Nick-Zuchlewski/nix-pill-v1/assembly/nix-pill-v1.xlsx

Designator | Package | Quantity | Designation | Part Number | Cost | Total | Link
C1,C4,C8,C10,C11,C12,C13 | C_0603_1608Metric | 7 | 100n | CL10B104KB8NNNL | $0.10 | $0.70 | https://www.digikey.com/en/products/detail/samsung-electro-mechanics/CL10B104KB8NNNL/3894274
C2,C5 | C_0603_1608Metric | 2 | 8pF | C1608CH2A080D080AA | $0.17 | $0.34 | https://www.digikey.com/en/products/detail/tdk-corporation/C1608CH2A080D080AA/3948350
C3,C6 | C_0603_1608Metric | 2 | 10pF | C1608CH2A100D080AA | $0.17 | $0.34 | https://www.digikey.com/en/products/detail/tdk-corporation/C1608CH2A100D080AA/3948352
C7 | CP_Elec_4x3 | 1 | 100n | 865230640001 | $0.17 | $0.17 | https://www.digikey.com/en/products/detail/w%C3%BCrth-elektronik/865230640001/5727861
C9 | CP_Elec_4x3 | 1 | 10u | UWX1C100MCL1GB | $0.25 | $0.25 | https://www.digikey.com/en/products/detail/nichicon/UWX1C100MCL1GB/589841
D1 | LED_0603_1608Metric | 1 | C13 | LTST-C190KRKT | $0.24 | $0.24 | https://www.digikey.com/en/products/detail/lite-on-inc/LTST-C190KRKT/386817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
D2 | LED_0603_1608Metric | 1 | PWR | LTST-C190KRKT | $0.24 | $0.24 | https://www.digikey.com/en/products/detail/lite-on-inc/LTST-C190KRKT/386817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
D3 | SOT-23 | 1 | BAT54C | BAT54CLT1G | $0.14 | $0.14 | https://www.digikey.com/en/products/detail/on-semiconductor/BAT54CLT1G/920481
J1 | PinHeader_1x20_P2.54mm_Vertical | 1 | LEFT | 22284205 | $1.17 | $1.17 | https://www.digikey.com/en/products/detail/molex/0022284205/313945
J2 | PinHeader_2x03_P2.54mm_Vertical | 1 | BOOT | 877580650 | $0.44 | $0.44 | https://www.digikey.com/en/products/detail/molex/0877580650/3264792
J3 | PinHeader_1x20_P2.54mm_Vertical | 1 | RIGHT | 22284205 | $1.17 | $1.17 | https://www.digikey.com/en/products/detail/molex/0022284205/313945
J4 | PinHeader_1x04_P2.54mm_Horizontal | 1 | SWD | PBC04SBAN | $0.45 | $0.45 | https://www.digikey.com/en/products/detail/sullins-connector-solutions/PBC04SBAN/860344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
J5 | USB_Micro-B_Amphenol_10103594-0001LF_Horizontal | 1 | USB_B_Micro | 10103594-0001LF | $0.75 | $0.75 | https://www.digikey.com/en/products/detail/amphenol-icc-fci/10103594-0001LF/2350351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
R1,R2 | R_0603_1608Metric | 2 | 100 | RT0603DRD07100RL | $0.17 | $0.34 | https://www.digikey.com/en/products/detail/yageo/RT0603DRD07100RL/1035412
R3,R4,R8 | R_0603_1608Metric | 3 | 10k | RT0603DRD0710KL | $0.17 | $0.51 | https://www.digikey.com/en/products/detail/yageo/RT0603DRD0710KL/1035416
R5 | R_0603_1608Metric | 1 | 10K | RT0603DRD0710KL | $0.17 | $0.17 | https://www.digikey.com/en/products/detail/yageo/RT0603DRD0710KL/1035417
R6,R7 | R_0603_1608Metric | 2 | 22 | RC0603JR-0722RL | $0.10 | $0.20 | https://www.digikey.com/en/products/detail/yageo/RC0603JR-0722RL/726743
R9 | R_0603_1608Metric | 1 | 1M | CPF0603B1M0E1 | $0.59 | $0.59 | https://www.digikey.com/en/products/detail/te-connectivity-passive-product/CPF0603B1M0E1/2389636
SW1 | SW_SPST_TL3305A | 1 | USER0 | TL3305AF160QG | $0.18 | $0.18 | https://www.digikey.com/en/products/detail/e-switch/TL3305AF160QG/5816181
SW2 | SW_SPST_TL3305A | 1 | NRST | TL3305AF160QG | $0.18 | $0.18 | https://www.digikey.com/en/products/detail/e-switch/TL3305AF160QG/5816182
U1 | SOT-223-3_TabPin2 | 1 | AMS1117-3.3 | LD1117S33TR | $0.41 | $0.41 | https://www.digikey.com/en/products/detail/stmicroelectronics/LD1117S33TR/585766
U2 | LQFP-48_7x7mm_P0.5mm | 1 | STM32F103C8Tx | STM32F103C8T6 | $5.77 | $5.77 | https://www.digikey.com/en/products/detail/stmicroelectronics/STM32F103C8T6/1646338
Y1 | Crystal_SMD_MicroCrystal_CC5V-T1A-2Pin_4.1x1.5mm | 1 | 32.768KHz LSE | CC5V-T1A-32.768KHZ-9PF-20PPM-TA-QC | $1.18 | $1.18 | https://www.digikey.com/en/products/detail/micro-crystal-ag/CC5V-T1A-32-768KHZ-9PF-20PPM-TA-QC/10499123
Y2 | Crystal_SMD_3225-4Pin_3.2x2.5mm | 1 | 8MHz HSE | RH100-8.000-10-1010-EXT-TR | $0.82 | $0.82 | https://www.digikey.com/en/products/detail/raltron-electronics/RH100-8-000-10-1010-EXT-TR/10272912
 |  |  |  |  | Total | $16.75
