Nick-Zuchlewski/nix-pill-v1/nix-pill-v1.kicad_pcb

## KiCad design nix-pill-v1.kicad_pcb (2021-02-02)

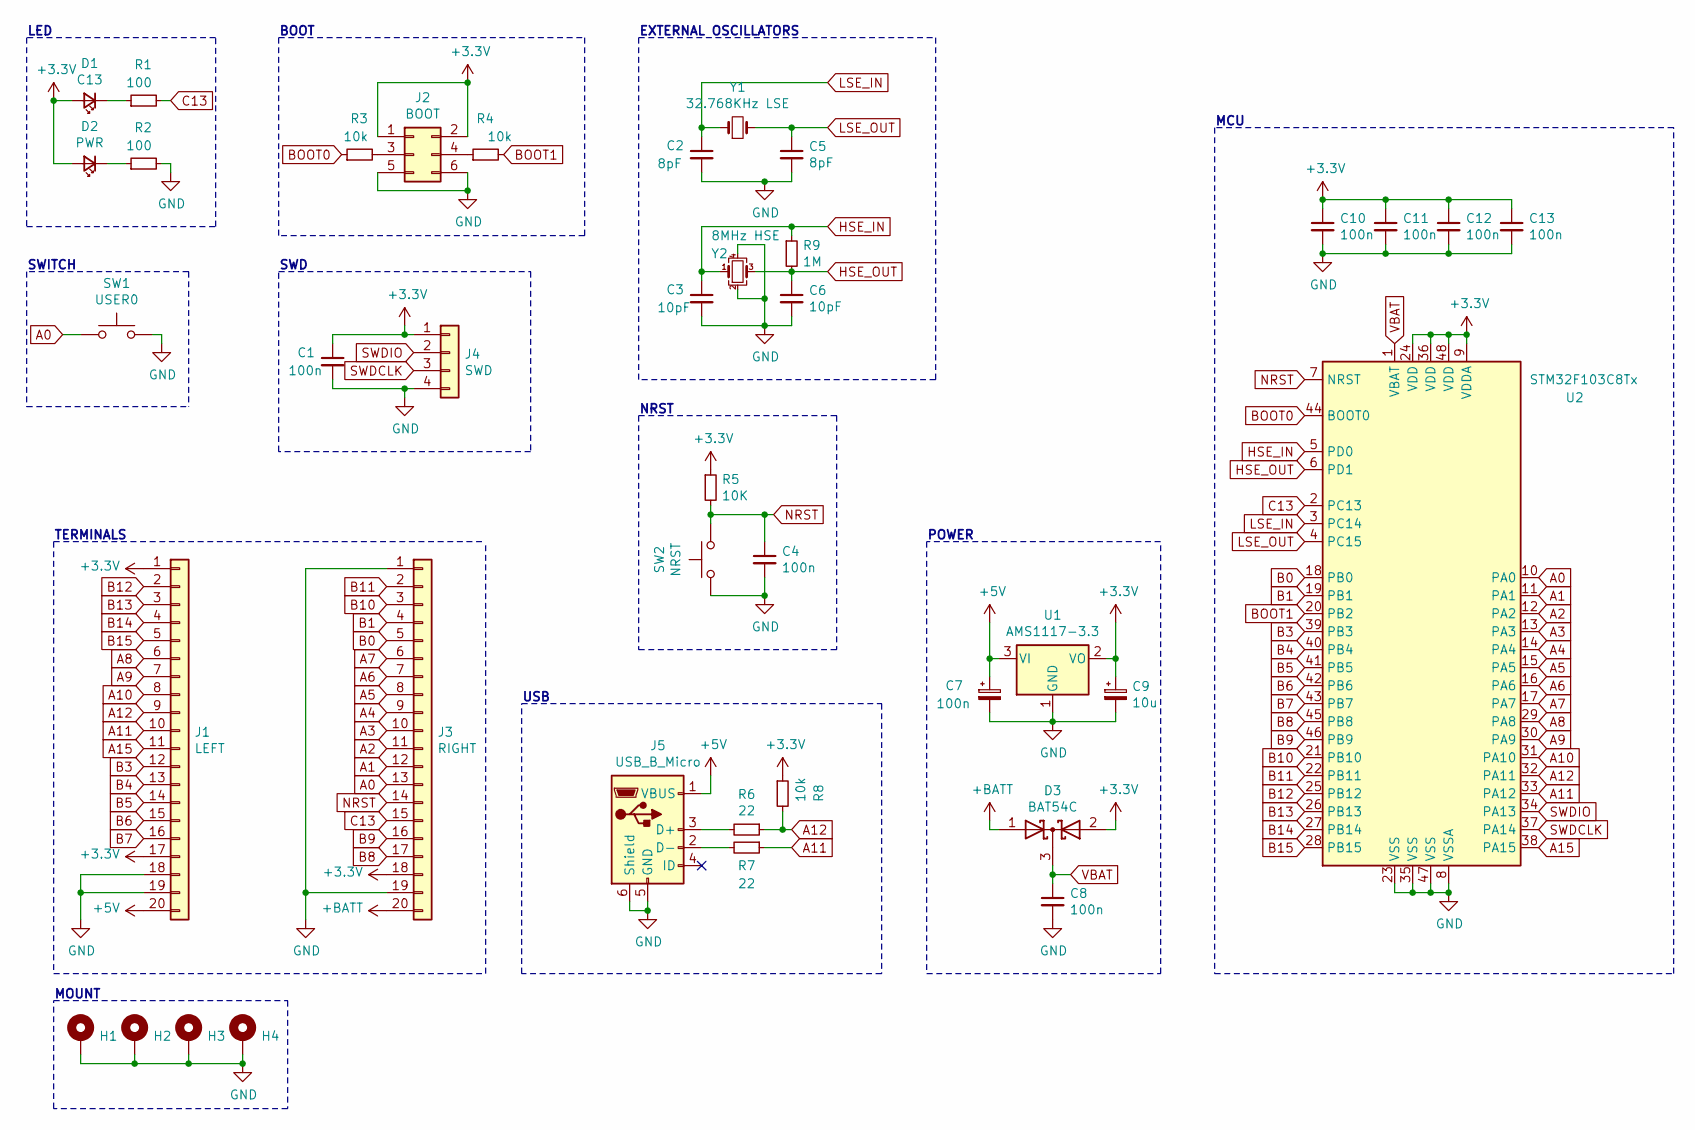
[picture p1: schematic nix-pill-v1.sch]

Parts:
C1, C4, C8, C10, C11, C12, C13: 100n; C_0603_1608Metric
C2, C5: 8pF; C_0603_1608Metric
C3, C6: 10pF; C_0603_1608Metric
C7: 100n; CP_Elec_4x3
C9: 10u; CP_Elec_4x3
D1: C13; LED_0603_1608Metric
D2: PWR; LED_0603_1608Metric
D3: BAT54C; SOT-23
H1, H2, H3, H4: MountingHole_Pad; MountingHole_4.3mm_M4_Pad_Via
J1: LEFT; PinHeader_1x20_P2.54mm_Vertical
J2: BOOT; PinHeader_2x03_P2.54mm_Vertical
J3: RIGHT; PinHeader_1x20_P2.54mm_Vertical
J4: SWD; PinHeader_1x04_P2.54mm_Horizontal
J5: USB_B_Micro; USB_Micro-B_Amphenol_10103594-0001LF_Horizontal
R1, R2: 100; R_0603_1608Metric
R3, R4, R8: 10k; R_0603_1608Metric
R5: 10K; R_0603_1608Metric
R6, R7: 22; R_0603_1608Metric
R9: 1M; R_0603_1608Metric
SW1: USER0; SW_SPST_TL3305A
SW2: NRST; SW_SPST_TL3305A
U1: AMS1117-3.3; SOT-223-3_TabPin2
U2: STM32F103C8Tx; LQFP-48_7x7mm_P0.5mm
Y1: 32.768KHz LSE; Crystal_SMD_MicroCrystal_CC5V-T1A-2Pin_4.1x1.5mm
Y2: 8MHz HSE; Crystal_SMD_3225-4Pin_3.2x2.5mm

Connections:
+3V3: C1.1, C9.1, C10.1, C11.1, C12.1, C13.1, D1.2 (A), D2.2 (A), D3.2 (A), J1.1, J1.17, J2.1, J2.2, J3.18, J4.1, R5.1, R8.1, U1.2 (VO), U2.9 (VDDA), U2.24 (VDD), U2.36 (VDD), U2.48 (VDD)
+5V: C7.1, J1.20, J5.1 (VBUS), U1.3 (VI)
+BATT: D3.1 (A), J3.20
A0: J3.13, SW1.1, U2.10 (PA0)
A1: J3.12, U2.11 (PA1)
A2: J3.11, U2.12 (PA2)
A3: J3.10, U2.13 (PA3)
A4: J3.9, U2.14 (PA4)
A5: J3.8, U2.15 (PA5)
A6: J3.7, U2.16 (PA6)
A7: J3.6, U2.17 (PA7)
A8: J1.6, U2.29 (PA8)
A9: J1.7, U2.30 (PA9)
A10: J1.8, U2.31 (PA10)
A11: J1.10, R7.1, U2.33 (PA12)
A12: J1.9, R6.1, R8.2, U2.32 (PA11)
A15: J1.11, U2.38 (PA15)
B0: J3.5, U2.18 (PB0)
B1: J3.4, U2.19 (PB1)
B3: J1.12, U2.39 (PB3)
B4: J1.13, U2.40 (PB4)
B5: J1.14, U2.41 (PB5)
B6: J1.15, U2.42 (PB6)
B7: J1.16, U2.43 (PB7)
B8: J3.17, U2.45 (PB8)
B9: J3.16, U2.46 (PB9)
B10: J3.3, U2.21 (PB10)
B11: J3.2, U2.22 (PB11)
B12: J1.2, U2.25 (PB12)
B13: J1.3, U2.26 (PB13)
B14: J1.4, U2.27 (PB14)
B15: J1.5, U2.28 (PB15)
BOOT0: R3.1, U2.44 (BOOT0)
BOOT1: R4.2, U2.20 (PB2)
C13: J3.15, R1.2, U2.2 (PC13)
GND: C1.2, C2.2, C3.2, C4.2, C5.2, C6.2, C7.2, C8.2, C9.2, C10.2, C11.2, C12.2, C13.2, H1.1, H2.1, H3.1, H4.1, J1.18, J1.19, J2.5, J2.6, J3.1, J3.19, J4.4, J5.5 (GND), J5.6 (Shield), R2.2, SW1.2, SW2.1, U1.1 (GND), U2.8 (VSSA), U2.23 (VSS), U2.35 (VSS), U2.47 (VSS), Y2.2, Y2.4
HSE_IN: C3.1, R9.1, U2.5 (PD0), Y2.1
HSE_OUT: C6.1, R9.2, U2.6 (PD1), Y2.3
LSE_IN: C2.1, U2.3 (PC14), Y1.1
LSE_OUT: C5.1, U2.4 (PC15), Y1.2
NRST: C4.1, J3.14, R5.2, SW2.2, U2.7 (NRST)
unnamed: D1.1 (K), R1.1
unnamed: D2.1 (K), R2.1
unnamed: J2.3, R3.2
unnamed: J2.4, R4.1
unnamed: J5.2 (D-), R7.2
unnamed: J5.3 (D+), R6.2
SWDCLK: J4.3, U2.37 (PA14)
SWDIO: J4.2, U2.34 (PA13)
VBAT: C8.1, D3.3 (K), U2.1 (VBAT)

Notes on the sheet:
POWER
SWD
NRST
EXTERNAL OSCILLATORS
TERMINALS
BOOT
USB
SWITCH
LED
MCU
MOUNT

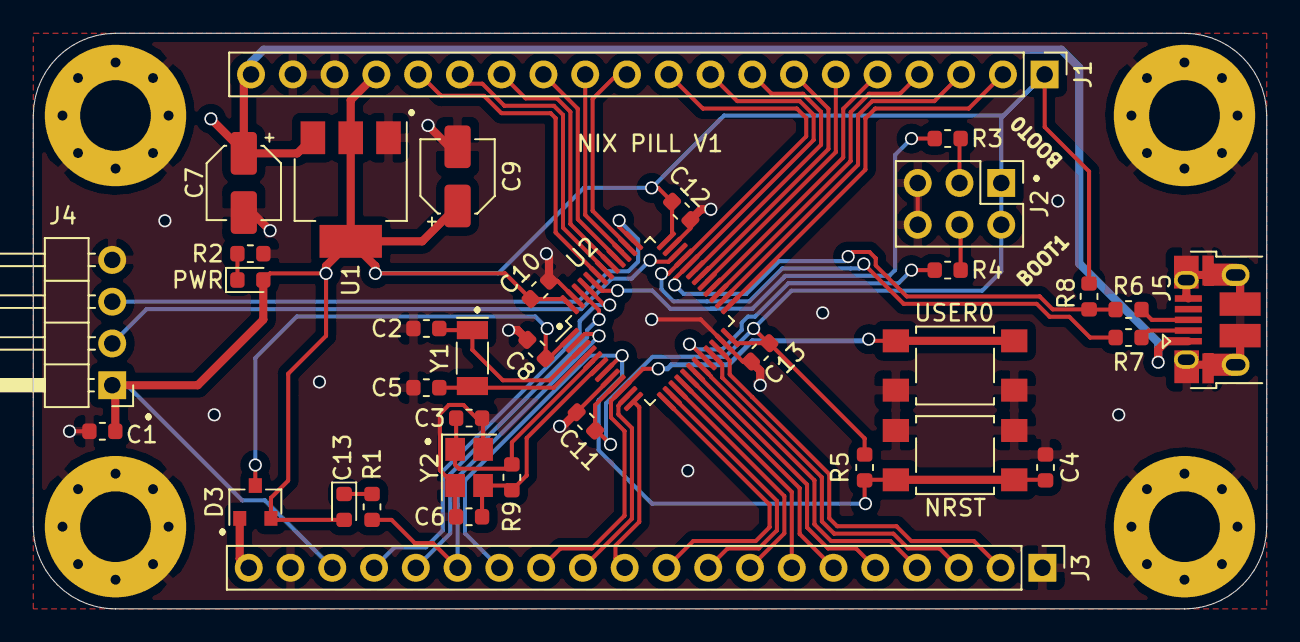
[picture p2: board nix-pill-v1.kicad_pcb from above]

Board: 2 copper layers, 75.0 x 35.0 mm, 40 parts (0 on the bottom side), 50 nets.
