Nick-Zuchlewski/nix-pill-v1/(commit log)

2021-01-25 init commit
    [nix-pill-v1-B_Cu.gbr, nix-pill-v1-B_Mask.gbr, nix-pill-v1-B_Paste.gbr, nix-pill-v1-B_SilkS.gbr, nix-pill-v1-Edge_Cuts.gbr, nix-pill-v1-F_Cu.gbr, nix-pill-v1-F_Mask.gbr, nix-pill-v1-F_Paste.gbr]
2021-01-26 Started adding data sheets Started the BOM Calculated the LED limiting R
    [nix-pill-v1.csv, nix-pill-v1.kicad_pcb, nix-pill-v1.sch]
2021-01-27 Added more data sheets and updated BOM
    [nix-pill-v1.kicad_pcb, nix-pill-v1.sch, nix-pill-v1.xlsx]
2021-01-28 BOM completed. Ordering PCB and parts
    [nix-pill-v1-B_Cu.gbr, nix-pill-v1-B_Mask.gbr, nix-pill-v1-B_Paste.gbr, nix-pill-v1-B_SilkS.gbr, nix-pill-v1-Edge_Cuts.gbr, nix-pill-v1-F_Cu.gbr, nix-pill-v1-F_Mask.gbr, nix-pill-v1-F_Paste.gbr]
2021-01-29 Testing the GH actions
    [nix-pill-v1.kicad_pcb]
2021-01-29 Adding own config with filter
2021-01-29 Set the board clearance to match board house.
    [nix-pill-v1.kicad_pcb]
2021-02-02 expirimenting with gerber generation
    [nix-pill-v1.kicad_pcb]
2021-02-02 removed gerbers update the action for gerbers, docs, and bom
    [nix-pill-v1-B_Cu.gbr, nix-pill-v1-B_Mask.gbr, nix-pill-v1-B_Paste.gbr, nix-pill-v1-B_SilkS.gbr, nix-pill-v1-Edge_Cuts.gbr, nix-pill-v1-F_Cu.gbr, nix-pill-v1-F_Mask.gbr, nix-pill-v1-F_Paste.gbr]
